sumran5zan/Night-Fury-SAE-ADC-/Final Model and Tests/IMG20190703165745.jpg

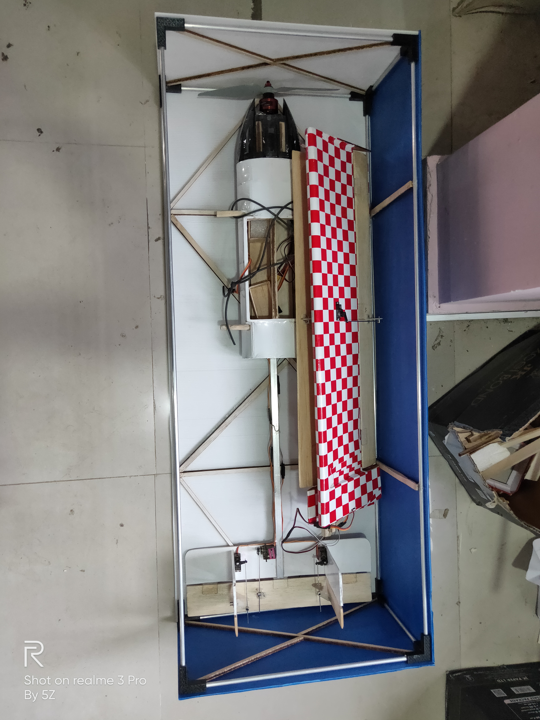
Final Model and Tests/IMG20190703165745.jpg
