sumran5zan/Night-Fury-SAE-ADC-/CAD Files/readme.txt

This folder contains all the CAD files of my model
