sumran5zan/Night-Fury-SAE-ADC-/Analysis/Nose cone/static pressure.PNG

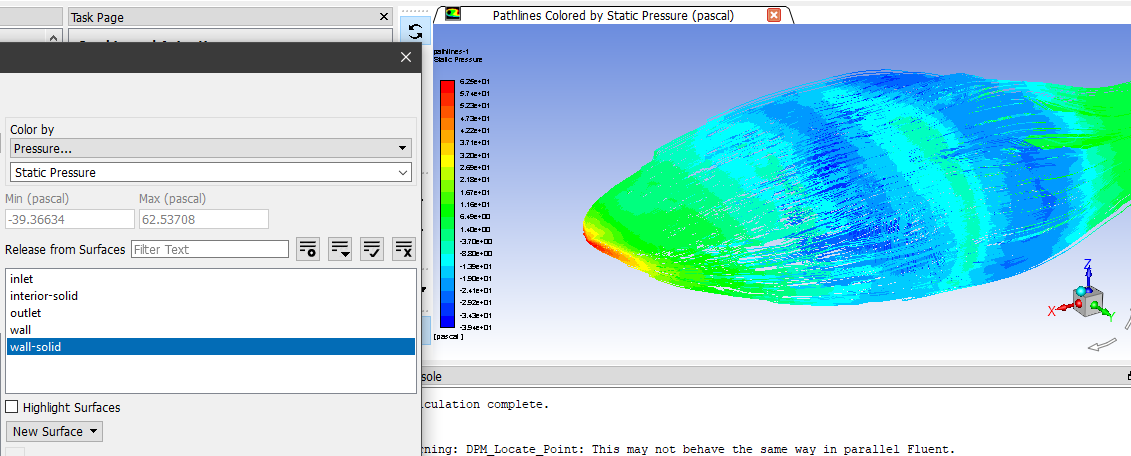
Analysis/Nose cone/static pressure.PNG
