sumran5zan/Night-Fury-SAE-ADC-/Analysis/Nose cone/velocity_x.PNG

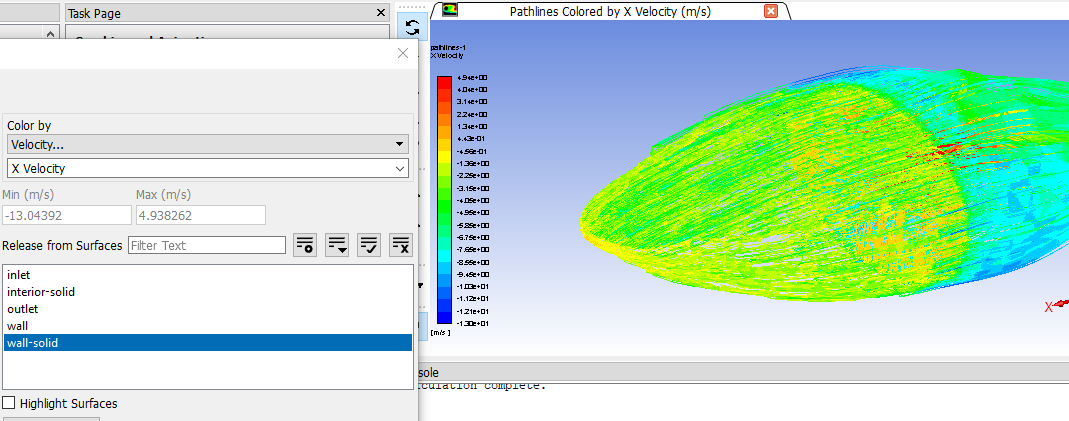
Analysis/Nose cone/velocity_x.PNG
