sumran5zan/Night-Fury-SAE-ADC-/Analysis/Wing Structural/Mesh_wing.PNG

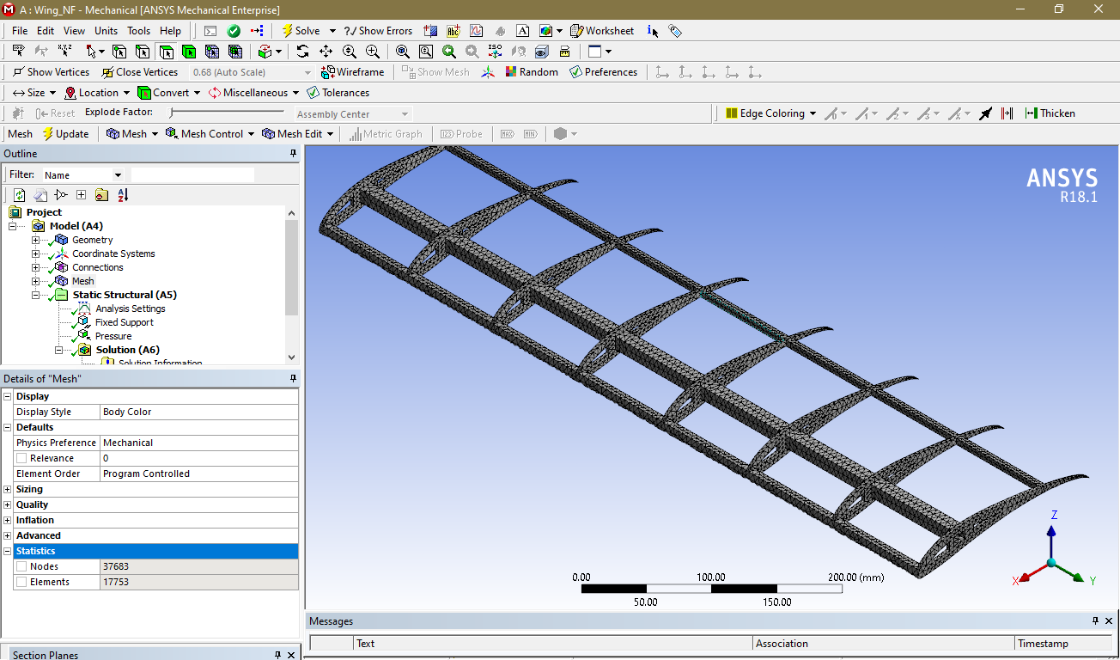
Analysis/Wing Structural/Mesh_wing.PNG
