sumran5zan/Night-Fury-SAE-ADC-/Analysis/Wing Structural/Spar_tot_def.PNG

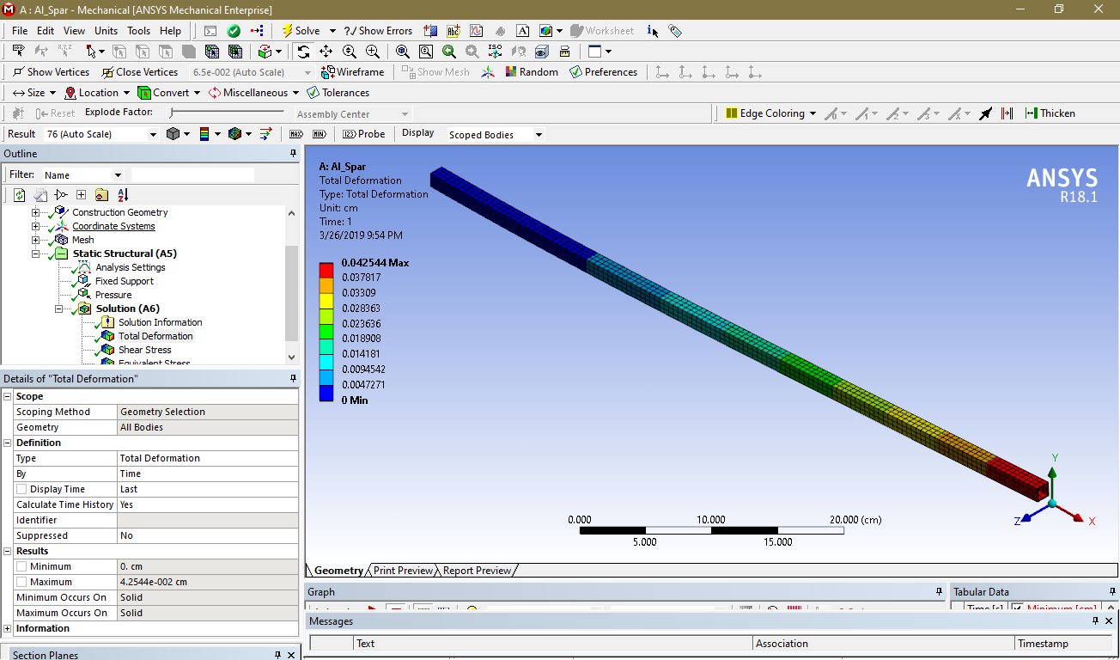
Analysis/Wing Structural/Spar_tot_def.PNG
