sumran5zan/Night-Fury-SAE-ADC-/Analysis/Wing Structural/Tot._Def_Wing.PNG

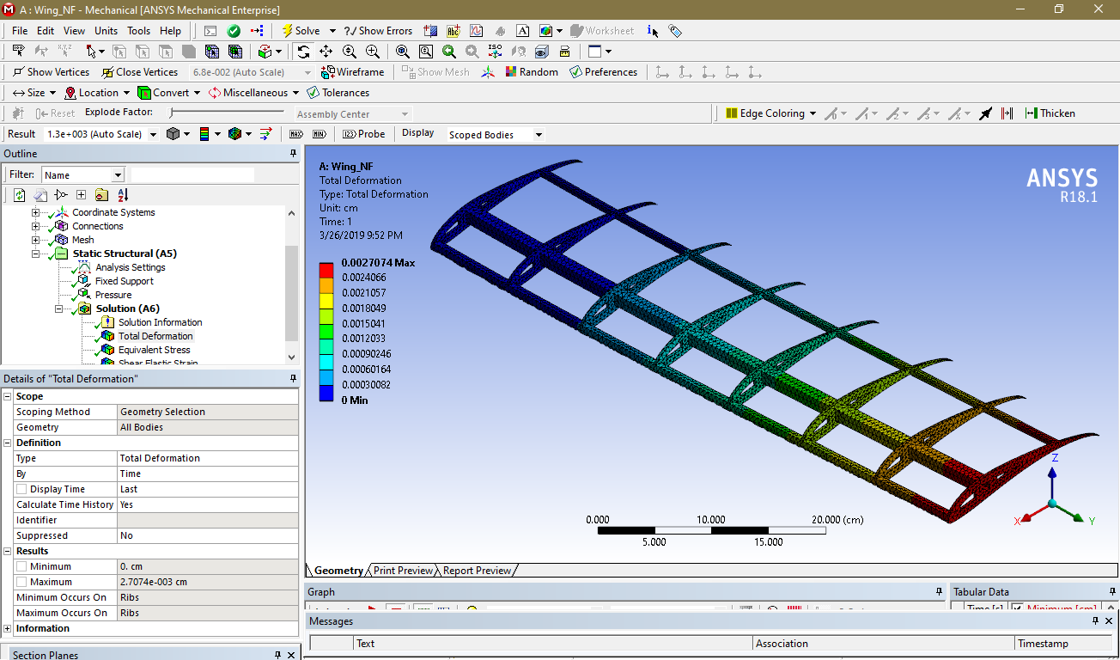
Analysis/Wing Structural/Tot._Def_Wing.PNG
