sumran5zan/Night-Fury-SAE-ADC-/Sizing and Calculations/Night Fury_v1004_Calculations.xlsx

Sheet: Intro
SAE ADC 2019
Night Fury

Sheet: Weight Buildup
Components Weight
S.no. | Components | Quantity | Weight (gm) | Wt. (Kg)
1 | Brushless DC Motor | 1 | 100 | 0.1
2 | ESC | 1 | 40 | 0.04
3 | Servos + Servo Extensions | 5 | 50 | 0.05 | Units Conversion
4 | 4 -cell LiPo Battery | 1 | 160 | 0.16 | 1 ft | 304.8 | mm
5 | Structural Weight | 1 | 1000 | 1 | 1 in | 25.4 | mm
6 | Reciever | 1 | 20 | 0.02 | 1 m | 100 | mm
7 | Payload | - | 1000 | 1
8 | Hinges, Wires ect., | 5 | 60 | 0.06
9 | Adhesive | 1 | 50 | 0.05
10 | Propeller | 1 | 20 | 0.02
 | TOTAL WEIGHT |  | 2500 | 2.5
 | Empty Wt. | 1500

Sheet: Airfoil Selection
S1223 | S1223 - Selig S1223 high lift low Reynolds number airfoil
 |  | Max thickness 12.1% at 19.8% chord.
 |  | Max camber 8.1% at 49% chord
 |  |  | Alpha(AOA) | Cl | Cd | Cm | Cl/Cd
Re. No. = 100,000 |  |  | 0 | 1.1729 | 0.02337 | -0.2688 | 50.18827557
Ncirt=9 |  |  | 3 | 1.5223 | 0.02811 | -0.2711 | 54.15510494
 |  | Max Cl | 9.75 | 2.0814 | 0.05612 | -0.2422 | 37.08838204
 |  | Stall | 10.75 | 2.0778 | 0.06333 | -0.2255 | 32.80909522

Sheet: Wing Calculations(Rectangle)
Wing Calculations (Rectangular Wing)
 |  |  |  |  |  |  |  | Vstall=sqrt((2*W*g)/(rho*S*Clmax)) |  |  | = | 8.93375771 | m/s |  | Vstall | 10
Weight, W | 2.5 | Kgs | 24.525 | N |  |  |  | V cruise= 1.2* Vstall |  |  | = | 10.72050925 | m/s
rho | 1.223 | Kg/m^3 |  |  |  |  |  | V td= 1.1*Vstall |  |  | = | 9.827133481 | m/s
L = 0.5*rho*V^2*S*Clmax |  |  |  | L=W | 2.5
 |  |  |  |  |  |  |  | Cl/Cd_max 54.5 at α=3.25° |  |  |  |  |  | L req | 3
AR = b^2/S |  |  |  | S=2*L/rho*V^2*Clmax |  |  |  | Cl at α=3.25° is 1.5379
 |  |  |  | S | 0.193 | m^2
S = b*C |  |  |  |  |  |  |  |  |  | To lift 2.5kg of weight, S |  | 0.193 | m^2
 |  |  |  | AR | Wing Span(b) (m) |  | Chord_C(m) |  |  | After Container Sizing |  | 0.241 | m^2
b = sqrt(AR*S) |  |  |  | 4 | 1.3 |  | 0.325
 |  |  |  | 5 | 1.3 |  | 0.26 |  |  |  |  | N | Kg
C = b/AR |  |  |  | 6 | 1.3 |  | 0.217 |  |  | Lift with S = | 0.1926890362 | 24.525 | 2.5
 |  |  |  | 7 | 1.3 |  | 0.186 |  |  | Lift with S = | 0.2414285714 | 30.728 | 3.132
 |  |  |  |  |  | Aerodynamic Center(a.c) |  |  | 0.046

Sheet: Wing Performance & Cruise Vel.
Wing Performance
Xfoil polar. Reynolds number fixed. Mach number fixed
Polar key | xf-s1223-il-100000
Airfoil | s1223-il
Reynolds number | 100000
Ncrit | 9
Mach | 0
Max Cl/Cd | 54.4775
Max Cl/Cd alpha | 3.25
Url | http://airfoiltools.com/polar/csv?polar=xf-s1223-il-100000
Alpha | Cl | Cd | Cdp | Cm | Top_Xtr | Bot_Xtr | V_Req (m/s)
-5.5 | -0.0105 | 0.10503 | 0.10101 | -0.0547 | 0.932 | 0.0686 | #NUM!
-5.25 | 0.0047 | 0.10263 | 0.09863 | -0.0592 | 0.9191 | 0.0714 | 188.002
-5 | 0.0103 | 0.10225 | 0.09828 | -0.0688 | 0.9014 | 0.0727 | 126.997
-4.75 | 0.0386 | 0.09558 | 0.09163 | -0.0648 | 0.8932 | 0.0746 | 65.602
-4.5 | 0.0702 | 0.09134 | 0.08739 | -0.0687 | 0.8858 | 0.0781 | 48.646
-4.25 | 0.0884 | 0.08839 | 0.08445 | -0.0731 | 0.8701 | 0.0821 | 43.350
-4 | 0.1103 | 0.08464 | 0.08072 | -0.0818 | 0.8534 | 0.0847 | 38.808
-3.75 | 0.1289 | 0.08072 | 0.07681 | -0.0783 | 0.8397 | 0.0874 | 35.899
-3.5 | 0.1542 | 0.07715 | 0.07323 | -0.0813 | 0.8248 | 0.0922 | 32.822
-3.25 | 0.1897 | 0.0726 | 0.06865 | -0.0923 | 0.8082 | 0.0983 | 29.592
-3 | 0.224 | 0.06862 | 0.06461 | -0.0931 | 0.7962 | 0.1062 | 27.233
-2.75 | 0.2714 | 0.06377 | 0.05965 | -0.1031 | 0.7789 | 0.1151 | 24.740
-2.5 | 0.3355 | 0.05889 | 0.05459 | -0.1188 | 0.7554 | 0.1284 | 22.252
-2.25 | 0.4065 | 0.05411 | 0.04954 | -0.1332 | 0.7308 | 0.1442 | 20.215
-2 | 0.4772 | 0.04983 | 0.04493 | -0.1458 | 0.7064 | 0.1612 | 18.658
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
10.5 | 1.9679 | 0.06835 | 0.06181 | -0.2157 | 0.3771 | 1 | 9.188
10.75 | 2.0778 | 0.06333 | 0.05652 | -0.2255 | 0.3721 | 1 | 8.941
11.5 | 1.8149 | 0.09405 | 0.0882 | -0.197 | 0.3552 | 1 | 9.567
11.75 | 1.4189 | 0.16839 | 0.16288 | -0.2248 | 0.3114 | 1 | 10.820

Sheet: Payload Fraction
Payload Fraction
Struct. Wt. (Kg) | Payload (Kg) | Total Wt. | Payload fraction | Vstall (m/s) | L (N) | L (KG) | Sw (m\s) | b (m) | AR
1.5 | 0.7 | 2.2 | 0.3181818182 | 18.06661853 | 59.34822315 | 6.049767905 | 0.1428571429 | 1 | 7
1.5 | 1 | 2.5 | 0.4 | 15.91659509 | 55.73649807 | 5.681600211 | 0.1728571429 | 1.1 | 7
1.5 | 1.5 | 3 | 0.5 | 14.65087859 | 56.20096889 | 5.72894688 | 0.2057142857 | 1.2 | 7
1.5 | 2 | 3.5 | 0.5714285714 | 13.48381707 | 55.86841878 | 5.695047786 | 0.2414285714 | 1.3 | 7
1.5 | 2.5 | 4 | 0.625 | 12.4290936 | 55.05401034 | 5.612029596 | 0.28 | 1.4 | 7
1.5 | 3 | 4.5 | 0.6666666667 | 11.48389659 | 53.95293013 | 5.499789005 | 0.3214285714 | 1.5 | 7
1.5 | 3.5 | 5 | 0.7 | 10.63923915 | 52.68840833 | 5.3708877 | 0.3657142857 | 1.6 | 7
1.5 | 4 | 5.5 | 0.7272727273 | 9.884370964 | 51.33929338 | 5.23336324 | 0.4128571429 | 1.7 | 7

Sheet: Transport Container
Transport Container
Dimensions(l*b*h)=3ft^3 |  |  |  |  |  | 1ft= | 0.3048 | m
 |  |  |  |  |  | 1ft= | 30.48 | cm
Twin Rudder
L | m |  | ft | cm | Volume (ft^3)
Span | 1.3 | 0.99 | 3.25 | 99 | 2.959548534
Fuselage | 0.91
Half Span | 0.65 |  |  |  |  |  |  |  | Granted
Motor | 0.05
Clearence | 0.03
B | m |  | ft | cm
HT Span | 0.3508968102 | 0.4008968102 | 1.315 | 40.08968102
Clearence | 0.05
H | m |  | ft | cm
VT Span | 0.1311555783 | 0.2111555783 | 0.693 | 21.11555783
Fuselage ht | 0.074
Clearence | 0.03
With Fold mechanism of VT & piece wing
L | m |  | ft | cm | Volume (ft^3)
Span | 1.3 | 0.99 | 3.25 | 99 | 2.992693259
Fuselage | 0.91
Half Span | 0.65
Motor | 0.05
Clearence | 0.03
B | m |  | ft | cm
HT Span | 0.3508968102 | 0.4808968102 | 1.578 | 48.08968102
Clearence | 0.03
H | m |  | ft | cm
VT Span | 0.2623111566 | 0.178 | 0.584 | 17.8
Fuselage ht | 0.074
Clearence | 0.03
2 Piece wing with conve tail
L | m |  | ft | cm | Volume (ft^3)
Span | 1.3 | 0.97 | 3.18 | 0 | 4.700894459 |  |  |  |  | L |  | b |  | h |  | Volume
Fuselage | 0.91 |  |  |  |  |  |  |  |  | ft | m | ft | m | ft | m | ft^3
Half Span | 0.65 |  |  |  |  |  |  |  |  | 3 | 0.914 | 1 | 0.305 | 1.000 | 0.305 | 3
Motor | 0.03 |  |  |  |  |  |  |  |  | 3.2 | 0.975 | 1 | 0.305 | 0.938 | 0.286 | 3
Clearence | 0.03 |  |  |  |  |  |  |  |  | 3.4 | 1.036 | 1 | 0.305 | 0.882 | 0.269 | 3
B | m |  | ft | cm |  |  |  |  |  | 3.6 | 1.097 | 1 | 0.305 | 0.833 | 0.254 | 3
HT Span | 0.3508968102 | 0.4008968102 | 1.315 | 0 |  |  |  |  |  | 3.95 | 1.204 | 1 | 0.305 | 0.759 | 0.231 | 3
Clearence | 0.05 |  |  |  |  |  |  |  |  | 4 | 1.219 | 1.1 | 0.335 | 0.680 | 0.207 | 2.992
H | m |  | ft | cm |  |  |  |  |  | 4.1 | 1.250 | 1 | 0.305 | 0.732 | 0.223 | 3
VT Span | 0.2623111566 | 0.3423111566 | 1.123 | 0 |  |  |  |  |  | 4.29 | 1.308 | 1 | 0.305 | 0.699 | 0.213 | 3
Fuselage ht | 0.074 |  |  |  |  |  |  |  |  | 4.4 | 1.341 | 1 | 0.305 | 0.682 | 0.208 | 3
Clearence | 0.03 |  |  |  |  |  |  |  |  | 3 | 0.914 | 1 | 0.305 | 1.000 | 0.305 | 3
 |  | 0.2184549087 | 0.7167155796 | Req. H
TB |  |  |  |  |  |  |  |  |  | L |  | b |  | h |  | Volume
3.15 | 1.25 | 0.75 | 2.953125 |  |  |  |  |  |  | ft | m | ft | m | ft | m | m^3
0.96012 | 0.381 | 0.2286 |  |  |  |  |  |  |  |  | 1.11 |  | 0.3762968102 |  | 0.3657111566 | 0.1699 | 0.1527536953

Sheet: Wing Loading
Wing Loading
At Stall Speed |  |  |  |  | In Crusie |  |  |  |  |  | In Loiter
 |  |  |  |  |  |  |  | n = load factor(lift/wt. of a.c)
W/S at Instantenous Turn |  |  |  | W/S at Sustained Turn |  |  |  | e = oswald efficiency
 |  |  |  |  |  |  |  | Cd0 = Zero lift drag coefficient
Cd0 | e | Pie | S or A | q | n | V_Stall (m/s) | W/S_stall (N/m^2) | W/S_cruise (N/m^2) | W/S_loiter (N/m^2) | W/S_instantaneous turn (N/m^2) | W/S_sustained turn (N/m^2)
0.02337 | 0.8 | 3.14159 | 0.2414285714 | 61.15 | 0.7981202683 | 10 | 127.278 | 7.282 | 12.612 | 159.472 | 9.124
0.02337 | 0.8 | 3.14159 | 0.2414285714 | 67.417875 | 0.7981202683 | 10.5 | 140.324 | 8.028 | 13.905 | 175.818 | 10.059
0.02337 | 0.8 | 3.14159 | 0.2414285714 | 73.9915 | 0.7981202683 | 11 | 154.006 | 8.811 | 15.261 | 192.961 | 11.040
0.02337 | 0.8 | 3.14159 | 0.2414285714 | 80.870875 | 0.7981202683 | 11.5 | 168.325 | 9.630 | 16.680 | 210.901 | 12.066
0.02337 | 0.8 | 3.14159 | 0.2414285714 | 88.056 | 0.7981202683 | 12 | 183.280 | 10.486 | 18.162 | 229.639 | 13.138
0.02337 | 0.8 | 3.14159 | 0.2414285714 | 95.546875 | 0.7981202683 | 12.5 | 198.871 | 11.378 | 19.707 | 249.175 | 14.256
0.02337 | 0.8 | 3.14159 | 0.2414285714 | 103.3435 | 0.7981202683 | 13 | 215.099 | 12.306 | 21.315 | 269.507 | 15.419

Sheet: Fuselage Sizing
Fuselage Sizing |  |  |  |  |  |  | Double Bubble Fuselage
Length of fuselage is about 60-75% of span |  |  |  | Span= | 1.3 | m | Payload Bay Dimensions |  |  | 1in= | 2.54 | cm
 |  |  |  |  |  |  |  |  |  |  |  |  | With Clearence
% | Actual | Wing Span(m) | Length of Fuselage(m) |  |  |  |  |  |  | l | 12.7 | cm | 6 | in
60 | 0.6 | 1.3 | 0.78 |  |  |  |  |  |  | w | 3.81 | cm | 2.5 | in
62 | 0.62 | 1.3 | 0.806 |  |  |  |  |  |  | h | 3.81 | cm | 2.5 | in
64 | 0.64 | 1.3 | 0.832
66 | 0.66 | 1.3 | 0.858
68 | 0.68 | 1.3 | 0.884 |  |  |  |  |  |  | Fuselage Dimensions
70 | 0.7 | 1.3 | 0.91 | Considered |  |  |  |  |  | Width of fuselage |  | 12.7 | cm | 5 | in
72 | 0.72 | 1.3 | 0.936 |  |  |  |  |  |  | Height of fuselage |  | 5.81 | cm | 2.5 | in
74 | 0.74 | 1.3 | 0.962 | Designed
75 | 0.75 | 1.3 | 0.975 |  |  |  |  |  |  |  |  |  | 6.35 | 0.0635
 |  |  |  |  |  |  |  |  |  | Battery Length |  | 4in
Dimensions
 |  |  |  |  |  |  |  | Motor
Exterior |  | Interior |  |  |  |  |  | SV
W (mm) | H (mm) | W (mm) | H (mm)
127 | 63.5 | 107 | 43.5
 |  |  |  |  |  |  |  | Boom
 |  |  |  |  |  |  |  | L | 0.755 | m
 |  |  |  |  |  |  |  | B | 0.012 | m
 |  |  |  |  |  |  |  | H | 0.012 | m
Dimensions V2
Exterior |  | Interior
W (mm) | H (mm) | W (mm) | H (mm)
119.1 | 78 | 99.1 | 58
 |  |  |  |  |  |  |  | Granted

Sheet: Nose Cone Design
Nose Cone Design
Design V1 (For optimised)
L (m) | R (m) | r_n (m) | rho (m) | x0 (m)
0.15 | 0.064 | 0.01 | 0.1 | 0.06751363749
0.15 | 0.064 | 0.02 | 0.15 | 0.05251153914 | T.V
0.15 | 0.064 | 0.02 | 0.2 | 0.03208477622
0.15 | 0.022 | 0.01 | 0.4 | 0.054 | S.V_up
0.15 | 0.042 | 0.01 | 0.17 | 0.054 | S.V_down
 |  |  |  |  |  | Top View | Side View
Design V2 (Double-Bubble)
L (m) | R (m) | r_n (m) | rho (m) | x0 (m) | meters
0.15 | 0.059 | 0.01 | 0.1 | 0.069881338
0.15 | 0.059 | 0.02 | 0.15 | 0.05716143043
0.15 | 0.059 | 0.02 | 0.2 | 0.03811166281 | T.V
0.15 | 0.029 | 0.01 | 0.35 | 0.03793305572 | S.V_up
0.15 | 0.039 | 0.01 | 0.24 | 0.03820107335 | S.V_down

Sheet: Tail Sizing
Tail Sizing
 |  |  |  |  |  |  |  |  |  |  |  |  | c_HT = | HT tail volume coeffifient
 |  |  |  |  |  |  |  |  |  |  |  |  | L_HT = | Moment Arm Length of HT
 |  |  |  |  |  |  |  |  |  |  |  |  | S_HT = | Surface Area of HT
 |  | Cht | Cvt
 |  | 0.5 | 0.04
 |  | For home built plane
Aspect Ratio |  |  | Surface Area
H.T is 3 to 5 |  |  | H.S is 15-25% of wing area
V.T is 3 to 5 |  |  | V.S is 7-12% of wing area
An aircraft with front mounted propeller has a tail moment arm of about 60% of the fuselage length |  |  |  |  |  |  |  |  |  | L_VT & L_HT | 0.546 | m
 |  |  |  |  |  |  |  |  |  | Required moment arm length
Horizontal Tail
% | S_ht (m^2) | c_ht (m) | C_W (m) | S_w (m^2) | L_ht (m) | AR | S_ht (m^2) | b_ht (m) | C_ht (m) |  | HT Dimensions
0.15 | 0.036 | 0.5 | 0.186 | 0.241 | 0.619 | 3 | 0.041 | 0.351 | 0.117 |  | HTML | 0.546 | m
0.17 | 0.041 | 0.5 | 0.186 | 0.241 | 0.546 | 3.5 | 0.041 | 0.379 | 0.108 |  | Sw | 0.241 | m^2
0.18 | 0.043 | 0.5 | 0.186 | 0.241 | 0.516 | 4 | 0.041 | 0.405 | 0.101 |  | MAC | 0.029 | m
0.21 | 0.051 | 0.5 | 0.186 | 0.241 | 0.442 | 4.5 | 0.041 | 0.430 | 0.096 |  | Sht | 0.041 | m^2
0.23 | 0.056 | 0.5 | 0.186 | 0.241 | 0.404 | 5 | 0.041 | 0.453 | 0.091
0.25 | 0.060 | 0.5 | 0.186 | 0.241 | 0.371
 |  |  |  |  |  |  |  |  |  | 0.1755
Vertical Tail
% | S_vt (m^2) | c_vt (m) | b_W (m) | S_w (m^2) | L_vt (m) | AR | S_vt (m^2) | b_vt (m) | C_vt (m) |  | VT Dimensions
0.07 | 0.017 | 0.04 | 1.3 | 0.241 | 0.743 | 3 | 0.023 | 0.262 | 0.087 |  | HTML | 0.547 | m |  | Taper Surface
0.074 | 0.018 | 0.04 | 1.3 | 0.241 | 0.703 | 3.5 | 0.023 | 0.283 | 0.081 |  | Sw | 0.241 | m^2 |  | Mean Chord | Ratio(x) | Cr | Ct | Tr
0.078 | 0.019 | 0.04 | 1.3 | 0.241 | 0.667 | 4 | 0.023 | 0.303 | 0.076 |  | MAC | 0.022 | m |  | 0.08743705219 | 0.04371852609 | 0.1311555783 | 0.01311555783 | 0.1
0.086 | 0.021 | 0.04 | 1.3 | 0.241 | 0.605 | 4.5 | 0.023 | 0.321 | 0.071 |  | Svt | 0.023 | m^2 |  | 0.08743705219 | 0.04371852609 | 0.1311555783 | 0.02623111566 | 0.2
0.095 | 0.023 | 0.04 | 1.3 | 0.241 | 0.547 | 5 | 0.023 | 0.339 | 0.068 |  |  |  |  |  | 0.1638265306 | 0.08191326531 | 0.2457397959 | 0.07372193878 | 0.3
0.096 | 0.023 | 0.04 | 1.3 | 0.241 | 0.542 | 2 | 0.023 | 0.214 | 0.107 |  |  |  |  |  | 0.08743705219 | 0.04371852609 | 0.1311555783 | 0.06557778914 | 0.5
0.1 | 0.024 | 1.04 | 1.3 | 0.241 | 13.520 | 2.5 | 0.023 | 0.239 | 0.096 |  |  |  |  |  | 0.08743705219 | 0.04371852609 | 0.1311555783 | 0.0918089048 | 0.7
0.11 | 0.027 | 2.04 | 1.3 | 0.241 | 24.109 | 8 | 0.023 | 0.428 | 0.054
0.12 | 0.029 | 3.04 | 1.3 | 0.241 | 32.933 | 9 | 0.023 | 0.454 | 0.050 |  |  |  |  |  | Svt | req_bvt | req_MAC | Tr
 |  |  |  |  |  |  |  |  |  |  |  |  |  |  | 0.023 | 0.14 | 0.1638265306 | 3.4
Twin Rudder Configuration |  |  |  |  |  |  |  |  |  |  | b | 0.140
 |  |  |  |  |  | Granted
Inverse Pie Tail configuration
b_vt (m) | b_vt/2 (m) | b_ht (m) | b_ht/2 (m) | Offset w.r.t FRL
0.262 | 0.131 | 0.351 | 0.175 | 0.088

Sheet: Control Surface Sizing
Control Surface Sizing
Ailerons
Aileron span is about 50-90% of wing span
Aileron Chord is about 15-25% of wing chord
% | Wing Span (m) | Aileron Span (m) |  | % | Wing Chord (m) |  | Aileron Chord (m)
0.5 | 1.3 | 0.65 |  | 0.15 | 0.186 |  | 0.028
0.55 | 1.3 | 0.715 |  | 0.18 | 0.186 |  | 0.033
0.6 | 1.3 | 0.78 |  | 0.21 | 0.186 |  | 0.039
0.65 | 1.3 | 0.845 |  | 0.24 | 0.186 |  | 0.045
0.7 | 1.3 | 0.91 |  | 0.25 | 0.186 |  | 0.046
0.75 | 1.3 | 0.975
0.8 | 1.3 | 1.04
0.85 | 1.3 | 1.105
0.9 | 1.3 | 1.17
Elevator and Rudder
Elevator and Rudder is about 25-50% of tail chord
Elevator |  |  |  | Rudder
 |  |  | Ref |  |  |  | Ref
% | C_ht (m) | Elevator (m) | HS_C (m) | % | C_vt (m) | Rudder (m) | VS_C (m)
0.25 | 0.117 | 0.029 | 0.088 | 0.25 | 0.087 | 0.022 | 0.066
0.3 | 0.117 | 0.035 | 0.082 | 0.3 | 0.087 | 0.026 | 0.061
0.35 | 0.117 | 0.041 | 0.076 | 0.35 | 0.087 | 0.031 | 0.057
0.4 | 0.117 | 0.047 | 0.070 | 0.4 | 0.087 | 0.035 | 0.052
0.45 | 0.117 | 0.053 | 0.064 | 0.45 | 0.087 | 0.039 | 0.048
0.5 | 0.117 | 0.058 | 0.058 | 0.5 | 0.087 | 0.044 | 0.044

Sheet: Drag Calculation
Drag calculations
 |  |  |  |  |  |  | pie | 3.14159 |  | Source
 |  |  |  |  |  |  |  |  |  | https://itsallrc.wordpress.com/2014/02/19/how-to-calculate-drag/
Induced Drag |  |  |  |  |  | Parasite Drag |  |  |  | Form Factor for tail and wing |  |  |  | Form Factor for fuselage |  |  |  |  | Flat plate coefficient |  |  |  | Drag |  |  |  | Drag Polar or Total Drag
 |  |  |  |  |  | Coefficient Lift
 |  |  |  |  |  |  |  |  |  |  |  |  |  |  |  |  |  |  | Reynolds Number
Induced Drag of Wing |  |  |  |  |  |  |  |  |  |  | Parasite Drag of Wing
rho (Kg/m^3) | V (m/s) | S (m^2) | W (Kg) | Cl | Cd0 | AR | e | pie | Cd |  | rho (Kg/m^3) | V (m/s) | l (Chord) | Mew | Re | Cf | t/c | C | FF | S_wet | S_ref | Cdf |  | At Cruise Condition |  |  | Cd | Drag (N) | %
1.223 | 11.9009451 | 0.2414285714 | 2.5 | 1.1729 | 0.02337 | 7 | 0.8 | 3.14159 | 0.102 |  | 1.223 | 11.9009451 | 0.1857142857 | 1.4207e-05 | 155569.47 | 0.006493281503 | 0.12 | 0.1857142857 | 1.2524416 | 0.507 | 0.2414285714 | 0.01707815734 |  | Induced Drag of Wing |  |  | 0.1015659823 | 1.49945487 | 53.12
 |  |  |  |  |  |  |  |  |  |  |  |  |  |  |  |  |  |  |  |  |  |  |  | Parasite Drag of Wing |  |  | 0.01707815734 | 0.2521309361 | 8.93
Total Drag (Cd_tot) at Cruise Speed |  |  |  |  |  |  | Wing Drag |  |  |  | Parasite Drag of Horizontal Tail |  |  |  |  |  |  |  |  |  |  |  |  | Parasite Drag of HT |  |  | 0.0174047465 | 0.2569524885 | 9.10
 |  |  |  |  |  |  | Drag | 1.499 | N |  |  |  |  |  |  |  |  |  |  |  |  |  |  | Parasite Drag of VT |  |  | 0.02047346694 | 0.3022571044 | 10.71
Cd | Cdf_Wing | Cdf_HT | Cdf_vt | Cdf_fuselage | Cd_tot |  |  | 0.153 | Kg |  | rho | V | l (Chord) | Mew | Re | Cf | t/c | C | FF | S_wet | S_ref | Cdf |  | Parasite Drag of Fuselage |  |  | 0.03 | 0.5118544093 | 18.13
0.1015659823 | 0.01707815734 | 0.0174047465 | 0.02 | 0.03 | 0.19 |  |  |  |  |  | 1.223 | 11.9009451 | 0.1169656034 | 1.4207e-05 | 97979.96 | 0.007188804235 | 0.034 | 0.1169656034 | 1.068478241 | 0.093 | 0.04104285714 | 0.0174047465 |  | Total Drag |  |  | 0.1911929503 | 2.822649809 | 100.00
 |  |  |  |  |  |  | Tot. Drag
 |  |  |  |  |  |  | Drag | 2.823 | N |  | Parasite Drag of Vertical Tail
 |  |  |  |  |  |  |  | 0.288 | Kg |  |  |  |  |  |  |  |  |  |  |  |  |  |  | At Cruise Condition |  |  | Cd | Drag (N) | %
 |  |  |  |  |  |  |  |  |  |  | rho | V | l (Chord) | Mew | Re | Cf | t/c | C | FF | S_wet | S_ref | Cdf |  | Induced Drag of Wing |  |  | 0.262 | 3.874618395 | 73.37
 |  | k | 0.05684109912 |  |  |  |  |  |  |  | 1.223 | 11.9009451 | 0.08743705219 | 1.4207e-05 | 73244.43 | 0.007680501468 | 0.046 | 0.08743705219 | 1.091757183 | 0.056 | 0.02293571429 | 0.02047346694 |  | Parasite Drag of Wing |  |  | 0.01815257603 | 0.267992963 | 5.07
 |  |  |  |  |  |  |  |  |  |  |  |  |  |  |  |  |  |  |  |  |  |  |  | Parasite Drag of HT |  |  | 0.01854573845 | 0.2737973602 | 5.18
 |  |  |  |  |  |  |  |  |  |  | Parasite Drag of Fuselage |  |  |  |  |  |  |  |  |  |  |  |  | Parasite Drag of VT |  |  | 0.02185210309 | 0.3226104022 | 6.11
 |  |  |  |  |  |  |  |  |  |  |  |  |  |  |  |  |  |  |  |  |  |  |  | Parasite Drag of Fuselage |  |  | 0.04 | 0.5417209154 | 10.26
 |  |  |  |  |  |  |  |  |  |  | rho | V | l (length) | Mew | Re | Cf | d | l (Length) | FF | S_wet | S_ref | Cdf |  | Total Drag |  |  | 0.3576923585 | 5.280740036 | 100.00
 |  |  |  |  |  |  |  |  |  |  | 1.223 | 11.9009451 | 0.455 | 1.4207e-05 | 381145.21 | 0.005388603337 | 0.156 | 0.455 | 1.583257329 | 0.242 | 0.05955 | 0.03
Induced Drag of Wing |  |  |  |  |  |  |  |  |  |  |  | Parasite Drag of Wing |  |  |  |  |  |  |  |  |  |  |  |  |  | Parasite Drag of Horizontal Tail
rho | V | S | W | Cl | Cd0 | AR | e | pie | Cd | Drag (N) |  | rho | V | l (Chord) | Mew | Re | Cf | t/c | C | FF | S_wet | S_ref | Cdf | Drag (N) |  | rho | V | l (Chord) | Mew | Re | Cf | t/c | C | FF | S_wet | S_ref | Cdf | Drag (N)
1.223 | 1 | 0.2414285714 | 2.5 | 166.1207526 | 0.02337 | 7 | 0.8 | 3.14159 | 1568.616 | 23158.042 |  | 1.223 | 1 | 0.1857142857 | 1.4207e-05 | 13072.027 | 0.0118187515 | 0.12 | 0.1857142857 | 1.2524416 | 0.507 | 0.2414285714 | 0.03108482168 | 0.4589163242 |  | 1.223 | 1 | 0.1169656034 | 1.4207e-05 | 8232.96 | 0.01344634915 | 0.034 | 0.1169656034 | 1.068478241 | 0.093 | 0.04104285714 | 0.03255482979 | 0.4806185789
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

Sheet: Servo Sizing
Servo Sizing
alpha in degrees | in radians | PI | Cl | V | s at c/4 | s at c/8 | force(c/4) | force(c/8) | chord(c/4) | chord(c/8) | torque req(N-m)
-10 | -0.174533 | 3.14159 | -1.096622255 | 11 | 0.06035714286 | 0.03017857143 | -4.905431232 | -2.452715616 | 0.05 | 0.02 | -0.228
-9 | -0.1570797 | 3.141592654 | -0.9869608631 | 11 | 0.06035714286 | 0.03017857143 | -4.414891838 | -2.207445919 | 0.05 | 0.02 | -0.205
-8 | -0.1396264 | 3.141592654 | -0.877298545 | 11 | 0.06035714286 | 0.03017857143 | -3.924348301 | -1.96217415 | 0.05 | 0.02 | -0.182
-7 | -0.1221731 | 3.141592654 | -0.7676362269 | 11 | 0.06035714286 | 0.03017857143 | -3.433804763 | -1.716902382 | 0.05 | 0.02 | -0.159
-6 | -0.1047198 | 3.141592654 | -0.6579739087 | 11 | 0.06035714286 | 0.03017857143 | -2.943261226 | -1.471630613 | 0.05 | 0.02 | -0.137
-5 | -0.0872665 | 3.141592654 | -0.5483115906 | 11 | 0.06035714286 | 0.03017857143 | -2.452717688 | -1.226358844 | 0.05 | 0.02 | -0.114
-4 | -0.0698132 | 3.141592654 | -0.4386492725 | 11 | 0.06035714286 | 0.03017857143 | -1.96217415 | -0.9810870752 | 0.05 | 0.02 | -0.091
-3 | -0.0523599 | 3.141592654 | -0.3289869544 | 11 | 0.06035714286 | 0.03017857143 | -1.471630613 | -0.7358153064 | 0.05 | 0.02 | -0.068
-2 | -0.0349066 | 3.141592654 | -0.2193246362 | 11 | 0.06035714286 | 0.03017857143 | -0.9810870752 | -0.4905435376 | 0.05 | 0.02 | -0.046
-1 | -0.0174533 | 3.141592654 | -0.1096623181 | 11 | 0.06035714286 | 0.03017857143 | -0.4905435376 | -0.2452717688 | 0.05 | 0.02 | -0.023
0 | 0 | 3.141592654 | 0 | 11 | 0.06035714286 | 0.03017857143 | 0 | 0 | 0.05 | 0.02 | 0.000
1 | 0.0174533 | 3.141592654 | 0.1096623181 | 11 | 0.06035714286 | 0.03017857143 | 0.4905435376 | 0.2452717688 | 0.05 | 0.02 | 0.023
2 | 0.0349066 | 3.141592654 | 0.2193246362 | 11 | 0.06035714286 | 0.03017857143 | 0.9810870752 | 0.4905435376 | 0.05 | 0.02 | 0.046
3 | 0.0523599 | 3.141592654 | 0.3289869544 | 11 | 0.06035714286 | 0.03017857143 | 1.471630613 | 0.7358153064 | 0.05 | 0.02 | 0.068
4 | 0.0698132 | 3.141592654 | 0.4386492725 | 11 | 0.06035714286 | 0.03017857143 | 1.96217415 | 0.9810870752 | 0.05 | 0.02 | 0.091
5 | 0.0872665 | 3.141592654 | 0.5483115906 | 11 | 0.06035714286 | 0.03017857143 | 2.452717688 | 1.226358844 | 0.05 | 0.02 | 0.114
6 | 0.1047198 | 3.141592654 | 0.6579739087 | 11 | 0.06035714286 | 0.03017857143 | 2.943261226 | 1.471630613 | 0.05 | 0.02 | 0.137
7 | 0.1221731 | 3.141592654 | 0.7676362269 | 11 | 0.06035714286 | 0.03017857143 | 3.433804763 | 1.716902382 | 0.05 | 0.02 | 0.159
8 | 0.1396264 | 3.141592654 | 0.877298545 | 11 | 0.06035714286 | 0.03017857143 | 3.924348301 | 1.96217415 | 0.05 | 0.02 | 0.182
9 | 0.1570797 | 3.141592654 | 0.9869608631 | 11 | 0.06035714286 | 0.03017857143 | 4.414891838 | 2.207445919 | 0.05 | 0.02 | 0.205
10 | 0.174533 | 3.141592654 | 1.096623181 | 11 | 0.06035714286 | 0.03017857143 | 4.905435376 | 2.452717688 | 0.05 | 0.02 | 0.228
 |  |  |  |  | Required max. Servo Force = |  |  |  | 0.23 | N-m

Sheet: Power Required
Power Required |  |  |  |  |  |  | https://www.banggood.in/QX-Motor-QAA2814-600KV-900KV-1250KV-3-6S-Brushless-Motor-CCW-For-RC-Airplane-Multicopter-p-1132193.html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
V | Cd | rho | Sw | D | Power=D*V
m/s |  | kg/m3 | m2 | N(kg-m/s2) | kgm2s-3
2 | 0.1911929503 | 1.223 | 0.2414285714 | 0.1129059924 | 0.226
2.5 | 0.1911929503 | 1.223 | 0.2414285714 | 0.1764156131 | 0.441
3 | 0.1911929503 | 1.223 | 0.2414285714 | 0.2540384828 | 0.762
3.5 | 0.1911929503 | 1.223 | 0.2414285714 | 0.3457746016 | 1.210
4 | 0.1911929503 | 1.223 | 0.2414285714 | 0.4516239694 | 1.806
4.5 | 0.1911929503 | 1.223 | 0.2414285714 | 0.5715865863 | 2.572
5 | 0.1911929503 | 1.223 | 0.2414285714 | 0.7056624522 | 3.528
5.5 | 0.1911929503 | 1.223 | 0.2414285714 | 0.8538515672 | 4.696
6 | 0.1911929503 | 1.223 | 0.2414285714 | 1.016153931 | 6.097
6.5 | 0.1911929503 | 1.223 | 0.2414285714 | 1.192569544 | 7.752
7 | 0.1911929503 | 1.223 | 0.2414285714 | 1.383098406 | 9.682
7.5 | 0.1911929503 | 1.223 | 0.2414285714 | 1.587740517 | 11.908
8 | 0.1911929503 | 1.223 | 0.2414285714 | 1.806495878 | 14.452
8.5 | 0.1911929503 | 1.223 | 0.2414285714 | 2.039364487 | 17.335
9 | 0.1911929503 | 1.223 | 0.2414285714 | 2.286346345 | 20.577
9.5 | 0.1911929503 | 1.223 | 0.2414285714 | 2.547441452 | 24.201
10 | 0.1911929503 | 1.223 | 0.2414285714 | 2.822649809 | 28.226
10.5 | 0.1911929503 | 1.223 | 0.2414285714 | 3.111971414 | 32.676
11 | 0.1911929503 | 1.223 | 0.2414285714 | 3.415406269 | 37.569
11.5 | 0.1911929503 | 1.223 | 0.2414285714 | 3.732954372 | 42.929
12 | 0.1911929503 | 1.223 | 0.2414285714 | 4.064615725 | 48.775
12.5 | 0.1911929503 | 1.223 | 0.2414285714 | 4.410390326 | 55.130
13 | 0.1911929503 | 1.223 | 0.2414285714 | 4.770278177 | 62.014
13.5 | 0.1911929503 | 1.223 | 0.2414285714 | 5.144279277 | 69.448
14 | 0.1911929503 | 1.223 | 0.2414285714 | 5.532393625 | 77.454
14.5 | 0.1911929503 | 1.223 | 0.2414285714 | 5.934621223 | 86.052
15 | 0.1911929503 | 1.223 | 0.2414285714 | 6.35096207 | 95.264
 |  |  |  |  |  | `

Sheet: Dynamic Thrust (Simplyfied)
Dynamic Thrust
 |  |  |  |  |  |  | Source
 |  |  |  |  |  |  | https://www.flitetest.com/articles/propeller-static-dynamic-thrust-calculation
 |  |  |  |  |  | Static Velocity |  | V=0m/s
 |  |  |  |  |  | Stall Velocity |  | V=11m/s |  |  | 3s Battery (V) | 11.1
 |  |  |  |  |  |  |  |  |  |  | Motor KV | 1250
 |  |  |  |  |  | Req. Thrust to Weight ratio |  |  | 0.7 |  | Max. RPM | 13875
 |  |  |  |  |  | Req. Thrust |  | 1.75 | kgs
 |  |  |  |  |  |  |  | 17.1675 | N
 |  |  |  |  |  |  |  |  |  |  |  |  | Selected Prop. 9X7 tri-blade
 |  |  | in
Prop. Diameter |  |  | 9 |  | Pitch |  | 5 | 6 | 7 | 8
Prop. Diameter |  |  | 10 |  | Pitch |  | 5 | 6 | 7 | 8
Static Thrust
9 |  | X | 5 |  | 9 |  | X | 6 |  |  | 9 |  | X | 7 |  | 9 |  | X | 8
RPM | Dia (in) | Pitch | V0 (m/s) | Static Thrust (N) | RPM | Dia (in) | Pitch | V0 (m/s) | Static Thrust (N) |  | RPM | Dia (in) | Pitch | V0 (m/s) | Static Thrust (N) | RPM | Dia (in) | Pitch | V0 (m/s) | Static Thrust (N)
0 | 9 | 5 | 0 | 0.000 | 0 | 9 | 6 | 0 | 0.000 |  | 0 | 9 | 7 | 0 | 0.000 | 0 | 9 | 8 | 0 | 0.000
1000 | 9 | 5 | 0 | 0.091 | 1000 | 9 | 6 | 0 | 0.100 |  | 1000 | 9 | 7 | 0 | 0.108 | 1000 | 9 | 8 | 0 | 0.115
2000 | 9 | 5 | 0 | 0.364 | 2000 | 9 | 6 | 0 | 0.398 |  | 2000 | 9 | 7 | 0 | 0.430 | 2000 | 9 | 8 | 0 | 0.460
3000 | 9 | 5 | 0 | 0.818 | 3000 | 9 | 6 | 0 | 0.897 |  | 3000 | 9 | 7 | 0 | 0.968 | 3000 | 9 | 8 | 0 | 1.035
4000 | 9 | 5 | 0 | 1.455 | 4000 | 9 | 6 | 0 | 1.594 |  | 4000 | 9 | 7 | 0 | 1.721 | 4000 | 9 | 8 | 0 | 1.840
5000 | 9 | 5 | 0 | 2.273 | 5000 | 9 | 6 | 0 | 2.490 |  | 5000 | 9 | 7 | 0 | 2.690 | 5000 | 9 | 8 | 0 | 2.876
6000 | 9 | 5 | 0 | 3.274 | 6000 | 9 | 6 | 0 | 3.586 |  | 6000 | 9 | 7 | 0 | 3.873 | 6000 | 9 | 8 | 0 | 4.141
7000 | 9 | 5 | 0 | 4.456 | 7000 | 9 | 6 | 0 | 4.881 |  | 7000 | 9 | 7 | 0 | 5.272 | 7000 | 9 | 8 | 0 | 5.636
8000 | 9 | 5 | 0 | 5.820 | 8000 | 9 | 6 | 0 | 6.375 |  | 8000 | 9 | 7 | 0 | 6.886 | 8000 | 9 | 8 | 0 | 7.361
9000 | 9 | 5 | 0 | 7.366 | 9000 | 9 | 6 | 0 | 8.069 |  | 9000 | 9 | 7 | 0 | 8.715 | 9000 | 9 | 8 | 0 | 9.317
10000 | 9 | 5 | 0 | 9.093 | 10000 | 9 | 6 | 0 | 9.961 |  | 10000 | 9 | 7 | 0 | 10.759 | 10000 | 9 | 8 | 0 | 11.502
11000 | 9 | 5 | 0 | 11.003 | 11000 | 9 | 6 | 0 | 12.053 |  | 11000 | 9 | 7 | 0 | 13.019 | 11000 | 9 | 8 | 0 | 13.918
12000 | 9 | 5 | 0 | 13.094 | 12000 | 9 | 6 | 0 | 14.344 |  | 12000 | 9 | 7 | 0 | 15.493 | 12000 | 9 | 8 | 0 | 16.563
13000 | 9 | 5 | 0 | 15.368 | 13000 | 9 | 6 | 0 | 16.834 |  | 13000 | 9 | 7 | 0 | 18.183 | 13000 | 9 | 8 | 0 | 19.439
Dynamic Thrust
9 |  | X | 5 |  | 9 |  | X | 6 |  |  | 9 |  | X | 7 |  | 9 |  | X | 8
RPM | Dia (in) | Pitch | V0 (m/s) | Static Thrust (N) | RPM | Dia (in) | Pitch | V0 (m/s) | Static Thrust (N) |  | RPM | Dia (in) | Pitch | V0 (m/s) | Static Thrust (N) | RPM | Dia (in) | Pitch | V0 (m/s) | Static Thrust (N)
0 | 9 | 5 | 11 | 0.000 | 0 | 9 | 6 | 11 | 0.000 |  | 0 | 9 | 7 | 11 | 0.000 | 0 | 9 | 8 | 11 | 0.000
1000 | 9 | 5 | 11 | -0.382 | 1000 | 9 | 6 | 11 | -0.332 |  | 1000 | 9 | 7 | 11 | -0.292 | 1000 | 9 | 8 | 11 | -0.259
2000 | 9 | 5 | 11 | -0.581 | 2000 | 9 | 6 | 11 | -0.464 |  | 2000 | 9 | 7 | 11 | -0.368 | 2000 | 9 | 8 | 11 | -0.287
3000 | 9 | 5 | 11 | -0.599 | 3000 | 9 | 6 | 11 | -0.398 |  | 3000 | 9 | 7 | 11 | -0.230 | 3000 | 9 | 8 | 11 | -0.086
4000 | 9 | 5 | 11 | -0.435 | 4000 | 9 | 6 | 11 | -0.132 |  | 4000 | 9 | 7 | 11 | 0.124 | 4000 | 9 | 8 | 11 | 0.346
5000 | 9 | 5 | 11 | -0.090 | 5000 | 9 | 6 | 11 | 0.333 |  | 5000 | 9 | 7 | 11 | 0.693 | 5000 | 9 | 8 | 11 | 1.008
6000 | 9 | 5 | 11 | 0.438 | 6000 | 9 | 6 | 11 | 0.998 |  | 6000 | 9 | 7 | 11 | 1.477 | 6000 | 9 | 8 | 11 | 1.899
7000 | 9 | 5 | 11 | 1.148 | 7000 | 9 | 6 | 11 | 1.861 |  | 7000 | 9 | 7 | 11 | 2.476 | 7000 | 9 | 8 | 11 | 3.021
8000 | 9 | 5 | 11 | 2.039 | 8000 | 9 | 6 | 11 | 2.924 |  | 8000 | 9 | 7 | 11 | 3.691 | 8000 | 9 | 8 | 11 | 4.373
9000 | 9 | 5 | 11 | 3.112 | 9000 | 9 | 6 | 11 | 4.186 |  | 9000 | 9 | 7 | 11 | 5.121 | 9000 | 9 | 8 | 11 | 5.954
10000 | 9 | 5 | 11 | 4.368 | 10000 | 9 | 6 | 11 | 5.647 |  | 10000 | 9 | 7 | 11 | 6.765 | 10000 | 9 | 8 | 11 | 7.766
11000 | 9 | 5 | 11 | 5.805 | 11000 | 9 | 6 | 11 | 7.308 |  | 11000 | 9 | 7 | 11 | 8.625 | 11000 | 9 | 8 | 11 | 9.808
12000 | 9 | 5 | 11 | 7.423 | 12000 | 9 | 6 | 11 | 9.167 |  | 12000 | 9 | 7 | 11 | 10.701 | 12000 | 9 | 8 | 11 | 12.080
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
12000 | 10 | 5 | 11 | 10.734 | 12000 | 10 | 6 | 11 | 13.255 |  | 12000 | 10 | 7 | 11 | 15.473 | 12000 | 10 | 8 | 11 | 17.467
13000 | 10 | 5 | 11 | 13.338 | 13000 | 10 | 6 | 11 | 16.233 |  | 13000 | 10 | 7 | 11 | 18.784 | 13000 | 10 | 8 | 11 | 21.085

Sheet: Dynamic Thrust (Expanded)
Dynamic Thrust
 |  |  |  |  |  |  | Prop
 | By: Gabriel Staples, 18 Sept 2013 |  |  |  |  |  | https://www.masterairscrew.com/collections/3-blade/products/3-blade-9x7-propeller
 | http://electricrcaircraftguy.blogspot.com/2013/09/propeller-static-dynamic-thrust-equation.html
 | Blog Home: | http://electricrcaircraftguy.blogspot.com/
 | Propeller Inputs
 | dia, d (in): | 9 | pitch (in): | 7 | RPMs: | 13000
 | x |  | y
 | Aircraft Airspeed, V0 (m/s) | Dynamic Thrust, F (N) | Dynamic Thrust, F (g) | Dynamic Thrust, F (kg) | Dynamic Thrust, F (oz) | Dynamic Thrust, F (lb)
Static Thrust --> | 0 | 18.18313556 | 1853.530638 | 1.853530638 | 65.38143974 | 4.086330716
all others are dynamic thrust | 1 | 17.71113239 | 1805.416146 | 1.805416146 | 63.68424912 | 3.980256543
 | 2 | 17.23912922 | 1757.301653 | 1.757301653 | 61.98705851 | 3.87418237
 | 3 | 16.76712604 | 1709.18716 | 1.70918716 | 60.2898679 | 3.768108198
 | 4 | 16.29512287 | 1661.072668 | 1.661072668 | 58.59267728 | 3.662034025
 | 5 | 15.8231197 | 1612.958175 | 1.612958175 | 56.89548667 | 3.555959852
 | 6 | 15.35111652 | 1564.843682 | 1.564843682 | 55.19829605 | 3.449885679
 | 7 | 14.87911335 | 1516.72919 | 1.51672919 | 53.50110544 | 3.343811506
 | 8 | 14.40711018 | 1468.614697 | 1.468614697 | 51.80391483 | 3.237737334
 | 9 | 13.93510701 | 1420.500205 | 1.420500205 | 50.10672421 | 3.131663161
 | 10 | 13.46310383 | 1372.385712 | 1.372385712 | 48.4095336 | 3.025588988
 | 11 | 12.99110066 | 1324.271219 | 1.324271219 | 46.71234299 | 2.919514815
 | 12 | 12.51909749 | 1276.156727 | 1.276156727 | 45.01515237 | 2.813440643
 | 13 | 12.04709431 | 1228.042234 | 1.228042234 | 43.31796176 | 2.70736647
 | 14 | 11.57509114 | 1179.927741 | 1.179927741 | 41.62077115 | 2.601292297
 | 15 | 11.10308797 | 1131.813249 | 1.131813249 | 39.92358053 | 2.495218124
 | 16 | 10.6310848 | 1083.698756 | 1.083698756 | 38.22638992 | 2.389143951
 | 17 | 10.15908162 | 1035.584263 | 1.035584263 | 36.52919931 | 2.283069779
 | 18 | 9.687078451 | 987.4697707 | 0.9874697707 | 34.83200869 | 2.176995606
 | 19 | 9.215075278 | 939.3552781 | 0.9393552781 | 33.13481808 | 2.070921433
 | 20 | 8.743072105 | 891.2407854 | 0.8912407854 | 31.43762747 | 1.96484726

Sheet: Model Details
Model Details
Model
Payload |  |  | 1 kgs
Empty Weight |  |  | 1.5 kgs
Gross Takeoff Weight |  |  | 3 kgs
Payload Fraction |  |  | 0.4
Wing
Airfoil
S1223 - Selig S1223 high lift low Reynolds number airfoil
Clmax | 2.0814
Stall Angle | 10.75 | Degree
Re | 1 lakh
Wing
AR |  |  | 7
Surface Area |  |  | 0.2414285714 | m^2
Chord |  |  | 0.1857142857 | m
Wing Span |  |  | 1.3 | m
MAC |  |  | 0.04642857143
L |  |  | 3.132359996 | Kgs
Aeliron
Span |  |  | 1.04 | m
Chord |  |  | 0.04642857143 | m
Fuselage
Fuselage Length without tail boom |  |  | 0.91 | m
Fuselage Length with tail boom |  |  | 0.455 | m
Crossection Dimensions
Exterior |  | Interior
W (m) | H (m) | W (m) | H (m)
0.1191 | 0.078 | 0.0991 | 0.058
Volume |  |  |  |  | Volume (Rect) |  |  | Graph
 |  |  |  |  |  |  |  | 0 | 0
 |  |  |  |  |  |  |  | 0.0192 | 0.0007
r | 0.116 | m |  |  | l | 0.455 | m
h | 0.455 | m |  |  | b | 0.04 | m
V | 0.0192 | m^3 |  |  | h | 0.04 | m
 |  |  |  |  | V | 0.0007 | m^3
Tail
Configuration : Tail Boom with Inverse Pie Tail
H - Tail
HTML |  |  | 0.546 | m
Surface Area of HT |  |  | 0.041 | m^2
Chord |  |  | 0.117 | m
Span |  |  | 0.351 | m
MAC |  |  | 0.029 | m
Elevator Chord |  |  | 0.053 | m
Twin Rudder - Tail
Total |  |  |  |  |  | Single Surface
HTML |  |  | 0.546 | m |  | HTML |  | 0.546 | m
Surface Area of VT |  |  | 0.023 | m^2 |  | Surface Area of VT |  | 0.011 | m^2
Chord |  |  | 0.087 | m |  | Chord |  | 0.087 | m
Span |  |  | 0.262 | m^2 |  | Span |  | 0.131 | m^2
MAC |  |  | 0.022 | m |  | MAC |  | 0.022 | m
Elevator Chord |  |  | 0.031 | m |  | Elevator Chord |  | 0.031 | m

Sheet: CE
CE
Motor | 2100
Esc | 1210
Servos | 1590
Propeller | 700
Al Rod | 700
Balsa Sheet | 3000
Laser Cutting | 5000
 | 14300
