sumran5zan/Night-Fury-SAE-ADC-/Analysis/Nose cone/nose_3d_v3.igs

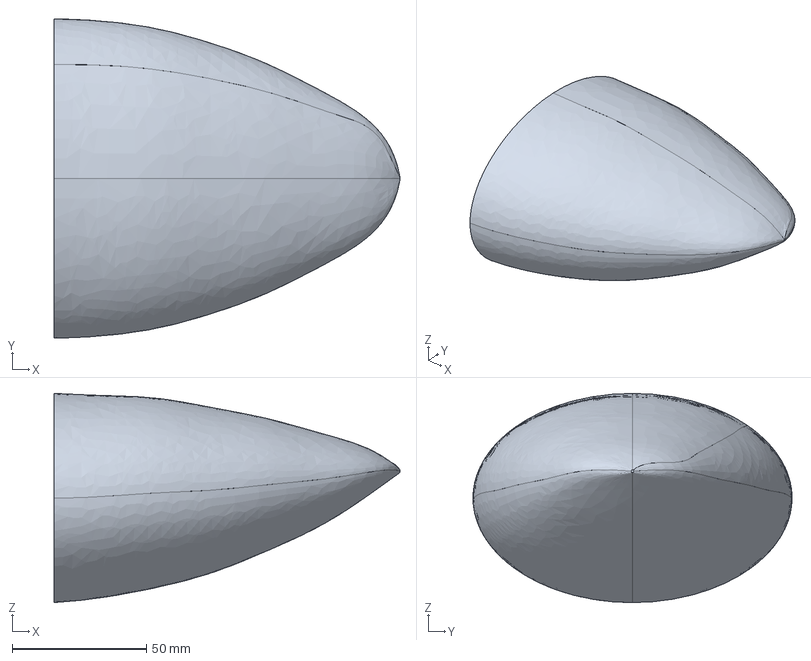
[picture p8: CAD file, 2024-03-26]
Analysis/Nose cone/nose_3d_v3.igs
129.0 x 119.0 x 78.0 mm
