sumran5zan/Night-Fury-SAE-ADC-/Analysis/Wing Structural/Wing_Static_Struct_half.igs

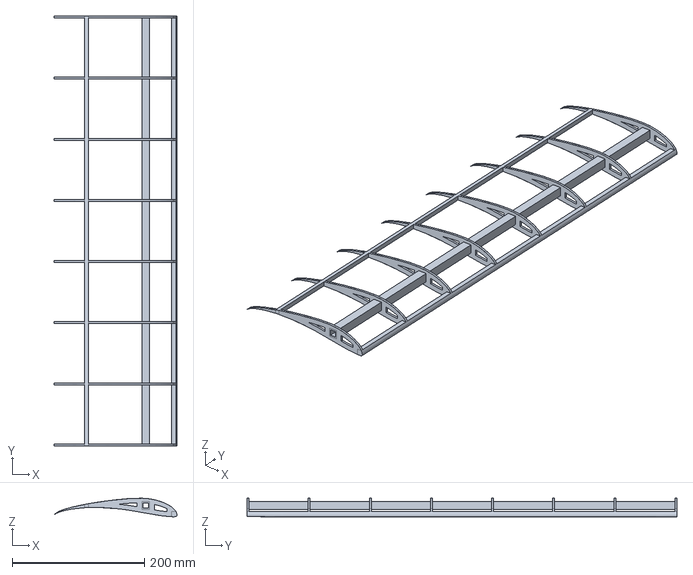
[picture p9: CAD file, 2024-03-26]
Analysis/Wing Structural/Wing_Static_Struct_half.igs
186.0 x 650.0 x 28.1 mm
