sumran5zan/Night-Fury-SAE-ADC-/Analysis/Wing Structural/Wing_Static_Structural.igs

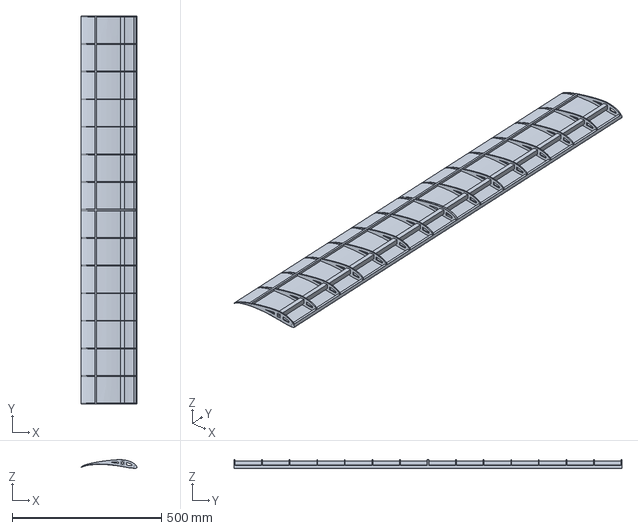
[picture p10: CAD file, 2024-03-26]
Analysis/Wing Structural/Wing_Static_Structural.igs
187.0 x 1300.0 x 29.1 mm
