sumran5zan/Night-Fury-SAE-ADC-/(list of files, cad)

Other CAD files:
CAD Files/Boom.CATPart
CAD Files/Container.CATPart
CAD Files/Container_v2.CATPart
CAD Files/Detail_Deign_assmebly_v2.CATProduct
CAD Files/Detail_Deign_assmebly_v2_with_box.CATProduct
CAD Files/Fuselage.CATPart
CAD Files/Fuselage_reference_layout.CATPart
CAD Files/H_Tail.CATPart
CAD Files/Inverse_Pie_Tail.CATProduct
CAD Files/Motor_mount_v1304.CATPart
CAD Files/Motor_v1304.CATPart
CAD Files/Nose_coul_v1404.CATPart
CAD Files/Nose_cowl_v1604.CATPart
CAD Files/Nose_hallow.CATPart
CAD Files/Nose_v1304.CATProduct
CAD Files/Payload_bay.CATPart
CAD Files/Twin_Rudd_VT.CATPart
CAD Files/Wing.CATPart
CAD Files/nose_3d_v3_motorcutout.CATPart
