sumran5zan/Night-Fury-SAE-ADC-/(commit log)

2024-03-26 Create CAD Model
2024-03-26 Create Wing structural
